Aayush2003/EEG-Data-Acquisition-System/README.md

# EEG Data Acquisition System

This repository contains all the work we've done as part of the course project in EE344: Electronic Design Lab

Team Members:
* Aayush Rajesh
* Anubhav Bhatla
* Aditya Sriram
* Ankith R
* Nithish Kumar Reddy
* Shivam Patel
