Aayush2003/EEG-Data-Acquisition-System/CAD/M4_Large_Front_Right.stl

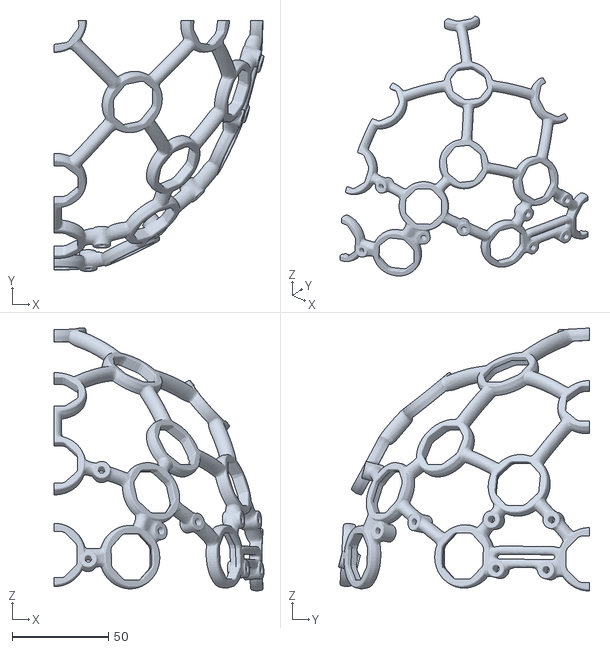
[picture p21: CAD file, 2023-04-30]
CAD/M4_Large_Front_Right.stl
108.9 x 130.1 x 136.4
