Aayush2003/EEG-Data-Acquisition-System/CAD/M4_Wire_Clip.stl

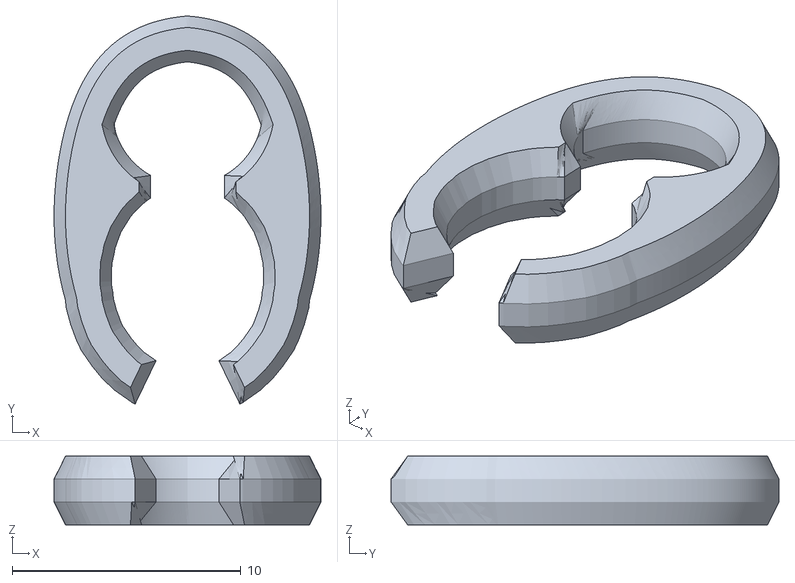
[picture p22: CAD file, 2023-04-30]
CAD/M4_Wire_Clip.stl
11.7 x 17.0 x 3.00
