Aayush2003/EEG-Data-Acquisition-System/CAD/M4_Hardware_insert_106_percent.STL

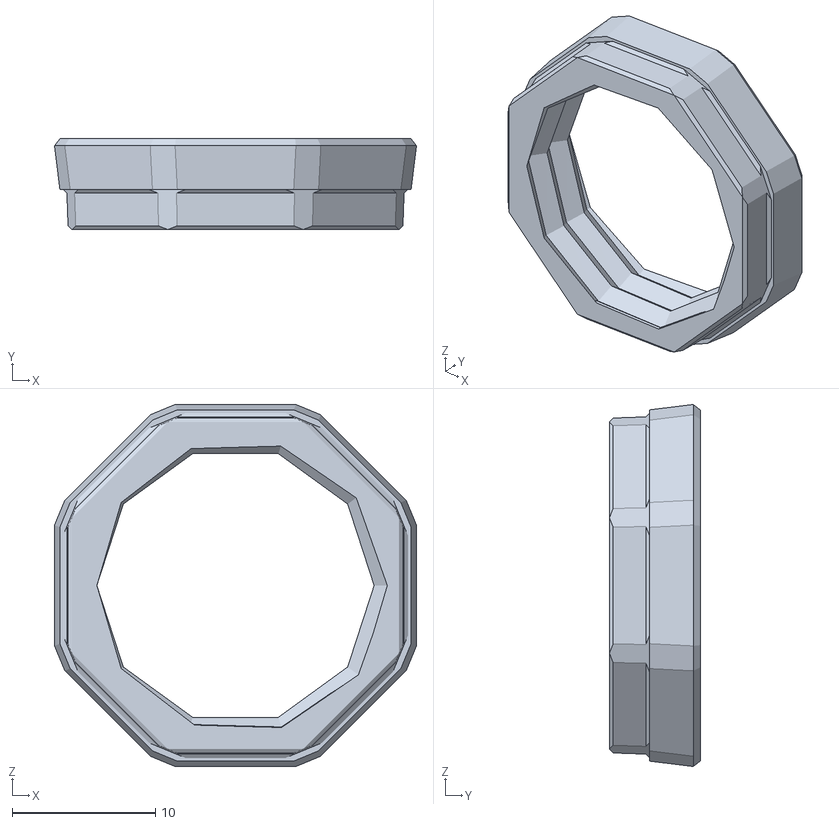
[picture p23: CAD file, 2023-04-30]
CAD/M4_Hardware_insert_106_percent.STL
25.3 x 6.35 x 25.3
