Aayush2003/EEG-Data-Acquisition-System/(list of files, cad)

Other CAD files:
CAD/M4_Large_Front_Left.stl
CAD/M4_Large_Back_Right-1.stl
CAD/M4_Large_Back_Left.stl
