Aayush2003/EEG-Data-Acquisition-System/Board Files/Main Board/OpenBCI_Board.brd

## EAGLE design Board Files/Main Board/OpenBCI_Board.brd (2023-04-30)

Schematic: OpenBCI_Board.sch

Parts:
C1: 10n; CAPC1608X85
C2, C4: 2.2u; CAPC1608X85
C3, C13, C23, C33, C41, C49, C56, C64, C124: 10u; CAPC3216X135
C5, C6, C8, C9, C15, C16, C19, C20, C24, C27, C29, C31, C35, C36, C38, C43, C44, C46, C51, C52, C54, C59, C60, C62, C67, C68, C70, C129, C131, C135, C137, C139, C141, C143, C145, C160, C162, C164, C166, C168, C170, C174, C176, C178, C180, C182, C184, C188, C190, C192, C194, C196, C198, C202, C204, C206, C208, C210, C212, C216, C218, C220, C222, C224, C226, C230, C232, C234, C236, C238, C240, C244, C246, C248, C250, C252, C254, C258, C260, C262, C264, C266, C268, C272, C274, C276, C278, C280, C282, C286, C288, C290, C292, C294, C296, C300: 1u; CAPC2012X110
C7, C12, C17, C21, C22, C26, C28, C30, C32, C37, C40, C45, C48, C53, C57, C61, C65, C69, C128, C130, C134, C136, C138, C140, C142, C144, C146, C147, C150, C151, C159, C161, C163, C165, C167, C169, C173, C175, C177, C179, C181, C183, C187, C189, C191, C193, C195, C197, C201, C203, C205, C207, C209, C211, C215, C217, C219, C221, C223, C225, C229, C231, C233, C235, C237, C239, C243, C245, C247, C249, C251, C253, C257, C259, C261, C263, C265, C267, C271, C273, C275, C277, C279, C281, C285, C287, C289, C291, C293, C295, C299: 0.1u; CAPC2012X110
C10, C11: 3.3u; CAPC1608X85
C14, C34, C42, C50, C58, C66: 22u; CAPC3216X135
C18: 10u; CAP_MCVV_A1_MTC-L
C25, C39, C47, C55, C63, C71: 100p; CAPC1608X85
C72, C73, C74, C76, C77, C78, C79, C80, C81, C82, C83, C84, C85, C86, C87, C88, C89, C90, C91, C92, C93, C94, C95, C96, C97, C98, C99, C100, C101, C102, C103, C104, C105, C106, C107, C108, C109, C110, C111, C112, C113, C114, C115, C116, C117, C118, C119, C121, C122, C123, C152, C153, C154, C155, C156: 10p; CAPC1608X85
C125, C126: 15p; CAPC1608X85
C127: 1.5n; CAPC1608X85
CR1, CR2: BAT85; DO-34_NEX
D1, D3: LED_BLUE; LEDC3216X75N_FLAT-B
D2: LED_BLUE; LEDC1005X25N_FLAT-B
ESP-BOOT: 10-XX; B3F-10XX
ESP-RST: 10-XX; B3F-10XX
FB1, FB2, FB3, FB5, FB6, FB9: FERRITE_BEAD; BEADC1608X95N
J3: SDCARD; GCT_MEM2051-00-195-00-A_REVD1
JP1, JP2, JP3, JP20, JP21, JP22: PINHD-2X5/90; 2X05/90
JP4, JP11, JP23: PINHD-1X2; 1X02
JP5, JP6: PINHD-2X2/90; 2X02/90
JP7: PINHD-1X10; 1X10
JP8: PINHD-1X8; 1X08
JP9, JP19: PINHD-1X4; 1X04
JP10: PINHD-1X3; 1X03
JP12: PINHD-1X7; 1X07
JP13, JP14, JP15, JP16, JP18: PINHD-1X1; 1X01
JP17: AGND; 1X01
MCLR/RESET: 10-XX; B3F-10XX
PIC-BOOT: PIC-BOOT; B3F-10XX
R1, R2, R4, R6, R7, R8, R61: 10k; RESC1608X60
R3, R5, R63, R66: 1k; RESC1608X60
R10, R11, R12, R13, R14, R15, R16, R17, R18, R19, R20, R21, R22, R23, R24, R25, R26, R27, R28, R29, R30, R31, R32, R33, R34, R35, R36, R37, R38, R39, R40, R41, R42, R43, R44, R45, R46, R47, R48, R49, R50, R51, R52, R53, R54, R55, R56, R57, R58, R59, R68, R69, R70, R71, R72: 5k; RESC1608X60
R62, R65: 1M; RESC1608X60
R64: 470k; RESC1608X60
R67: 0; RESC1608X60
U1: ESP-07SESP-07S_RFS-L; ESP-07S_RFS-L
U2: TPS72325DBVTDBV0005A; DBV0005A
U3: TLV70012QDDCRQ1DDC5_TEX-L; DDC5_TEX-L
U4, U6: AP2112K-3.3TRG1SOT_RG1_DIO-L; SOT_RG1_DIO-L
U5: LM2664M6; SOT95P280X145-6N
U7: LIS3DHHTRQFN; QFN_ICLX_STM
U8, U9, U10, U11, U12, U13: ADS1194CPAGPAG64-L; PAG64-L
U14, U15, U16, U17, U18, U19, U20, U21, U22, U23, U24, U25, U26, U27, U30: TPD4E1B; DCK6_TEX-L
U28: PIC32MX250F128D-50I/PTTQFP44_MC_MCH-L; TQFP44_MC_MCH-L
XTAL1: 8M; XTALRR488W45L1150T500H350B

Connections:
1N: JP20.7, R57.1, U25.4 (IO3)
1P: JP20.8, R58.1, U26.1 (IO1)
2N: JP20.5, R55.1, U25.2 (IO2)
2P: JP20.6, R56.1, U25.5 (IO4)
3N: JP20.3, R53.1, U24.4 (IO3)
3P: JP20.4, R54.1, U25.1 (IO1)
3V3: C19.1, C22.1, C23.1, D2.A, JP9.1, R1.2, R2.2, R4.2, U1.8 (VCC), U4.5 (VOUT)
4N: JP20.1, R51.1, U24.2 (IO2)
4P: JP20.2, R52.1, U24.5 (IO4)
5N: JP21.7, R49.1, U23.4 (IO3)
5P: JP21.8, R50.1, U24.1 (IO1)
6N: JP21.5, R47.1, U23.2 (IO2)
6P: JP21.6, R48.1, U23.5 (IO4)
7N: JP21.3, R45.1, U22.4 (IO3)
7P: JP21.4, R46.1, U23.1 (IO1)
8N: JP21.1, R43.1, U22.2 (IO2)
8P: JP21.2, R44.1, U22.5 (IO4)
9N: JP1.7, R41.1, U21.4 (IO3)
9P: JP1.8, R42.1, U22.1 (IO1)
10N: JP1.5, R39.1, U21.2 (IO2)
10P: JP1.6, R40.1, U21.5 (IO4)
11N: JP1.3, R37.1, U20.4 (IO3)
11P: JP1.4, R38.1, U21.1 (IO1)
12N: JP1.1, R35.1, U20.2 (IO2)
12P: JP1.2, R36.1, U20.5 (IO4)
13N: JP22.7, R33.1, U19.4 (IO3)
13P: JP22.8, R34.1, U20.1 (IO1)
14N: JP22.5, R31.1, U19.2 (IO2)
14P: JP22.6, R32.1, U19.5 (IO4)
15N: JP22.3, R29.1, U18.4 (IO3)
15P: JP22.4, R30.1, U19.1 (IO1)
16N: JP22.1, R27.1, U18.2 (IO2)
16P: JP22.2, R28.1, U18.5 (IO4)
17N: JP2.7, R25.1, U17.4 (IO3)
17P: JP2.8, R26.1, U18.1 (IO1)
18N: JP2.5, R23.1, U17.2 (IO2)
18P: JP2.6, R24.1, U17.5 (IO4)
19N: JP2.3, R21.1, U16.4 (IO3)
19P: JP2.4, R22.1, U17.1 (IO1)
20N: JP2.1, R19.1, U16.2 (IO2)
20P: JP2.2, R20.1, U16.5 (IO4)
21N: JP3.7, R17.1, U15.4 (IO3)
21P: JP3.8, R18.1, U16.1 (IO1)
22N: JP3.5, R15.1, U15.2 (IO2)
22P: JP3.6, R16.1, U15.5 (IO4)
23N: JP3.3, R13.1, U14.4 (IO3)
23P: JP3.4, R14.1, U15.1 (IO1)
24N: JP3.1, R11.1, U14.2 (IO2)
24P: JP3.2, R12.1, U14.5 (IO4)
-RAW: C4.1, C11.1, U2.2 (IN), U2.3 (EN), U5.2 (OUT)
AGND: C1.2, C2.2, C4.2, C5.2, C6.2, C11.2, C26.2, C27.2, C28.2, C29.2, C30.2, C31.2, C72.2, C73.2, C74.1, C74.2, C76.2, C77.2, C78.2, C79.2, C80.2, C81.2, C82.2, C83.2, C84.2, C85.2, C86.2, C87.2, C88.2, C89.2, C90.2, C91.2, C92.2, C93.2, C94.2, C95.2, C96.2, C97.2, C98.2, C99.2, C100.2, C101.2, C102.2, C103.2, C104.2, C105.2, C106.2, C107.2, C108.2, C109.2, C110.2, C111.2, C112.2, C113.2, C114.2, C115.2, C116.2, C117.2, C118.2, C119.2, C121.2, C122.2, C123.2, C128.2, C129.2, C130.2, C131.2, C134.2, C135.2, C136.2, C137.2, C138.2, C139.2, C140.2, C141.2, C142.2, C143.2, C144.2, C145.2, C152.2, C153.2, C154.2, C155.2, C156.2, C159.2, C160.2, C161.2, C162.2, C163.2, C164.2, C165.2, C166.2, C167.2, C168.2, C169.2, C170.2, C173.2, C174.2, C175.2, C176.2, C177.2, C178.2, C179.2, C180.2, C181.2, C182.2, C183.2, C184.2, C187.2, C188.2, C189.2, C190.2, C191.2, C192.2, C193.2, C194.2, C195.2, C196.2, C197.2, C198.2, C201.2, C202.2, C203.2, C204.2, C205.2, C206.2, C207.2, C208.2, C209.2, C210.2, C211.2, C212.2, C215.2, C216.2, C217.2, C218.2, C219.2, C220.2, C221.2, C222.2, C223.2, C224.2, C225.2, C226.2, C229.2, C230.2, C231.2, C232.2, C233.2, C234.2, C235.2, C236.2, C237.2, C238.2, C239.2, C240.2, C243.2, C244.2, C245.2, C246.2, C247.2, C248.2, C249.2, C250.2, C251.2, C252.2, C253.2, C254.2, C257.2, C258.2, C259.2, C260.2, C261.2, C262.2, C263.2, C264.2, C265.2, C266.2, C267.2, C268.2, C271.2, C272.2, C273.2, C274.2, C275.2, C276.2, C277.2, C278.2, C279.2, C280.2, C281.2, C282.2, C285.2, C286.2, C287.2, C288.2, C289.2, C290.2, C291.2, C292.2, C293.2, C294.2, C295.2, C296.2, C299.2, C300.2, FB1.2, FB2.2, FB3.2, FB5.2, FB6.2, FB9.2, JP4.2, JP5.3, JP5.4, JP6.3, JP6.4, JP8.2, JP11.1, JP12.7, JP13.1, JP14.1, JP15.1, JP16.1, JP17.1, JP23.2, R10.1, R10.2, U2.1 (GND), U3.2 (GND), U5.1 (GND), U8.31 (RESV1), U8.33 (DGND_2), U8.49 (DGND_3), U8.51 (DGND), U8.52 (CLKSEL), U8.60 (RLDINV_2), U9.31 (RESV1), U9.33 (DGND_2), U9.49 (DGND_3), U9.51 (DGND), U9.52 (CLKSEL), U9.60 (RLDINV_2), U10.31 (RESV1), U10.33 (DGND_2), U10.49 (DGND_3), U10.51 (DGND), U10.52 (CLKSEL), U10.60 (RLDINV_2), U11.31 (RESV1), U11.33 (DGND_2), U11.49 (DGND_3), U11.51 (DGND), U11.52 (CLKSEL), U11.60 (RLDINV_2), U12.31 (RESV1), U12.33 (DGND_2), U12.49 (DGND_3), U12.51 (DGND), U12.52 (CLKSEL), U12.60 (RLDINV_2), U13.31 (RESV1), U13.33 (DGND_2), U13.41 (DAISY_IN), U13.49 (DGND_3), U13.51 (DGND), U13.60 (RLDINV_2), U14.3 (GND), U15.3 (GND), U16.3 (GND), U17.3 (GND), U18.3 (GND), U19.3 (GND), U20.3 (GND), U21.3 (GND), U22.3 (GND), U23.3 (GND), U24.3 (GND), U25.3 (GND), U26.3 (GND), U27.1 (IO1), U27.3 (GND), U30.3 (GND)
AVDD: C5.1, C26.1, C27.1, C30.1, C31.1, C130.1, C131.1, C134.1, C135.1, C136.1, C137.1, C163.1, C164.1, C167.1, C168.1, C169.1, C170.1, C173.1, C174.1, C175.1, C176.1, C191.1, C192.1, C195.1, C196.1, C197.1, C198.1, C201.1, C202.1, C203.1, C204.1, C219.1, C220.1, C223.1, C224.1, C225.1, C226.1, C229.1, C230.1, C231.1, C232.1, C247.1, C248.1, C251.1, C252.1, C253.1, C254.1, C257.1, C258.1, C259.1, C260.1, C275.1, C276.1, C279.1, C280.1, C281.1, C282.1, C285.1, C286.1, C287.1, C288.1, JP5.1, JP5.2, U3.5 (OUT), U8.1 (IN8N), U8.2 (IN8P), U8.3 (IN7N), U8.4 (IN7P), U8.5 (IN6N), U8.6 (IN6P), U8.7 (IN5N), U8.8 (IN5P), U8.17 (TESTP_PACE_OUT1), U8.18 (TESTN_PACE_OUT2), U8.19 (AVDD_2), U8.21 (AVDD_3), U8.22 (AVDD_4), U8.42 (GPIO1), U8.44 (GPIO2), U8.45 (GPIO3), U8.46 (GPIO4), U8.54 (AVDD1), U8.56 (AVDD_5), U8.59 (AVDD), U9.1 (IN8N), U9.2 (IN8P), U9.3 (IN7N), U9.4 (IN7P), U9.5 (IN6N), U9.6 (IN6P), U9.7 (IN5N), U9.8 (IN5P), U9.17 (TESTP_PACE_OUT1), U9.18 (TESTN_PACE_OUT2), U9.19 (AVDD_2), U9.21 (AVDD_3), U9.22 (AVDD_4), U9.42 (GPIO1), U9.44 (GPIO2), U9.45 (GPIO3), U9.46 (GPIO4), U9.54 (AVDD1), U9.56 (AVDD_5), U9.59 (AVDD), U10.1 (IN8N), U10.2 (IN8P), U10.3 (IN7N), U10.4 (IN7P), U10.5 (IN6N), U10.6 (IN6P), U10.7 (IN5N), U10.8 (IN5P), U10.17 (TESTP_PACE_OUT1), U10.18 (TESTN_PACE_OUT2), U10.19 (AVDD_2), U10.21 (AVDD_3), U10.22 (AVDD_4), U10.42 (GPIO1), U10.44 (GPIO2), U10.45 (GPIO3), U10.46 (GPIO4), U10.54 (AVDD1), U10.56 (AVDD_5), U10.59 (AVDD), U11.1 (IN8N), U11.2 (IN8P), U11.3 (IN7N), U11.4 (IN7P), U11.5 (IN6N), U11.6 (IN6P), U11.7 (IN5N), U11.8 (IN5P), U11.17 (TESTP_PACE_OUT1), U11.18 (TESTN_PACE_OUT2), U11.19 (AVDD_2), U11.21 (AVDD_3), U11.22 (AVDD_4), U11.42 (GPIO1), U11.44 (GPIO2), U11.45 (GPIO3), U11.46 (GPIO4), U11.54 (AVDD1), U11.56 (AVDD_5), U11.59 (AVDD), U12.1 (IN8N), U12.2 (IN8P), U12.3 (IN7N), U12.4 (IN7P), U12.5 (IN6N), U12.6 (IN6P), U12.7 (IN5N), U12.8 (IN5P), U12.17 (TESTP_PACE_OUT1), U12.18 (TESTN_PACE_OUT2), U12.19 (AVDD_2), U12.21 (AVDD_3), U12.22 (AVDD_4), U12.42 (GPIO1), U12.44 (GPIO2), U12.45 (GPIO3), U12.46 (GPIO4), U12.54 (AVDD1), U12.56 (AVDD_5), U12.59 (AVDD), U13.1 (IN8N), U13.2 (IN8P), U13.3 (IN7N), U13.4 (IN7P), U13.5 (IN6N), U13.6 (IN6P), U13.7 (IN5N), U13.8 (IN5P), U13.17 (TESTP_PACE_OUT1), U13.18 (TESTN_PACE_OUT2), U13.19 (AVDD_2), U13.21 (AVDD_3), U13.22 (AVDD_4), U13.42 (GPIO1), U13.44 (GPIO2), U13.45 (GPIO3), U13.46 (GPIO4), U13.52 (CLKSEL), U13.54 (AVDD1), U13.56 (AVDD_5), U13.59 (AVDD), U27.2 (IO2)
AVSS: C2.1, C12.2, C13.2, C14.2, C15.2, C16.2, C17.2, C24.2, C25.2, C32.2, C33.2, C34.2, C35.2, C36.2, C37.2, C38.2, C39.2, C40.2, C41.2, C42.2, C43.2, C44.2, C45.2, C46.2, C47.2, C48.2, C49.2, C50.2, C51.2, C52.2, C53.2, C54.2, C55.2, C56.2, C57.2, C58.2, C59.2, C60.2, C61.2, C62.2, C63.2, C64.2, C65.2, C66.2, C67.2, C68.2, C69.2, C70.2, C71.2, C128.1, C129.1, C138.1, C139.1, C140.1, C141.1, C142.1, C143.1, C144.1, C145.1, C165.1, C166.1, C177.1, C178.1, C179.1, C180.1, C181.1, C182.1, C183.1, C184.1, C193.1, C194.1, C205.1, C206.1, C207.1, C208.1, C209.1, C210.1, C211.1, C212.1, C221.1, C222.1, C233.1, C234.1, C235.1, C236.1, C237.1, C238.1, C239.1, C240.1, C249.1, C250.1, C261.1, C262.1, C263.1, C264.1, C265.1, C266.1, C267.1, C268.1, C277.1, C278.1, C289.1, C290.1, C291.1, C292.1, C293.1, C294.1, C295.1, C296.1, JP6.1, JP6.2, U2.5 (OUT), U8.20 (AVSS_2), U8.23 (AVSS_3), U8.25 (VREFN), U8.32 (AVSS_4), U8.53 (AVSS1), U8.57 (AVSS_5), U8.58 (AVSS), U9.20 (AVSS_2), U9.23 (AVSS_3), U9.25 (VREFN), U9.32 (AVSS_4), U9.53 (AVSS1), U9.57 (AVSS_5), U9.58 (AVSS), U10.20 (AVSS_2), U10.23 (AVSS_3), U10.25 (VREFN), U10.32 (AVSS_4), U10.53 (AVSS1), U10.57 (AVSS_5), U10.58 (AVSS), U11.20 (AVSS_2), U11.23 (AVSS_3), U11.25 (VREFN), U11.32 (AVSS_4), U11.53 (AVSS1), U11.57 (AVSS_5), U11.58 (AVSS), U12.20 (AVSS_2), U12.23 (AVSS_3), U12.25 (VREFN), U12.32 (AVSS_4), U12.53 (AVSS1), U12.57 (AVSS_5), U12.58 (AVSS), U13.20 (AVSS_2), U13.23 (AVSS_3), U13.25 (VREFN), U13.32 (AVSS_4), U13.53 (AVSS1), U13.57 (AVSS_5), U13.58 (AVSS), U26.4 (IO3)
BATT1: CR1.2, JP4.1
BATT2: CR2.2, JP23.1
BOOT_EN: JP7.9, PIC-BOOT.1 (S), PIC-BOOT.2 (S1), R64.2, U28.2 (RPC6/PMA1/RC6)
CS_ACC: U7.4 (CS), U28.38 (RPC5/PMA3/RC5)
CS_ADC: U8.39 (!CS), U9.39 (!CS), U10.39 (!CS), U11.39 (!CS), U12.39 (!CS), U13.39 (!CS), U28.33 (SOSCI/RPB4/RB4)
CS_DAISY: JP8.8, U28.25 (AN6/RPC0/RC0)
CS_SD: J3.P2 (DATA3/CD), U28.37 (RPC4/PMA4/RC4)
DAISY_3_4: U10.41 (DAISY_IN), U11.43 (DOUT)
DGND: C3.2, C7.2, C8.2, C9.2, C18.1, C19.2, C20.2, C21.2, C22.2, C23.2, C124.1, C125.2, C126.2, C146.2, C147.2, C150.2, C151.1, ESP-BOOT.1 (S), ESP-BOOT.2 (S1), ESP-RST.3, ESP-RST.4 (P1), FB1.1, FB2.1, FB3.1, FB5.1, FB6.1, FB9.1, J3.P6 (VSS), JP7.3, JP7.10, JP9.2, JP10.3, JP18.1, MCLR/RESET.3, MCLR/RESET.4 (P1), R5.2, R6.1, R63.1, R64.1, U1.9 (GND), U4.2 (GND), U6.2 (GND), U7.9 (GND_2), U7.10 (GND_3), U7.11 (GND_4), U7.12 (GND_5), U7.13 (GND_6), U7.14 (GND_7), U7.15 (GND_8), U7.16 (GND), U28.6 (VSS_2), U28.15 (AN9/C3INA/RPB15/SCK2/CTED6/PMCS1/RB15), U28.16 (AVSS), U28.19 (PGED3/VREF+/CVREF+/AN0/C3INC/RPA0/CTED1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), U28.23 (AN4/C1INB/C2IND/RPB2/SDA2/CTED13/PMD2/R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), U28.24 (AN5/C1INA/C2INC/RTCC/RPB3/SCL2/PMWR/RB3), U28.27 (AN8/RPC2/PMA2/RC2), U28.29 (VSS_3), U28.32 (TDO/RPA8/PMA8/RA8), U28.35 (TDI/RPA9/PMA9/RA9), U28.39 (VSS), U28.44 (RPB8/SCL1/CTED10/PMD4/RB8)
DRDY: U8.47 (!DRDY), U28.43 (RPB7/CTED3/PMD5/INT0/RB7)
DVDD: C3.1, C6.1, C7.1, C8.1, C18.2, C21.1, C28.1, C29.1, C146.1, C147.1, C150.1, C159.1, C160.1, C161.1, C162.1, C187.1, C188.1, C189.1, C190.1, C215.1, C216.1, C217.1, C218.1, C243.1, C244.1, C245.1, C246.1, C271.1, C272.1, C273.1, C274.1, C299.1, C300.1, J3.P4 (VDD), JP7.2, JP8.1, PIC-BOOT.3, PIC-BOOT.4 (P1), R61.1, U3.1 (IN), U3.3 (EN), U5.4 (!SD), U5.5 (V+), U6.5 (VOUT), U7.7 (VDDIO), U7.8 (VDD), U8.35 (!PWDN), U8.48 (DVDD_2), U8.50 (DVDD), U9.35 (!PWDN), U9.48 (DVDD_2), U9.50 (DVDD), U10.35 (!PWDN), U10.48 (DVDD_2), U10.50 (DVDD), U11.35 (!PWDN), U11.48 (DVDD_2), U11.50 (DVDD), U12.35 (!PWDN), U12.48 (DVDD_2), U12.50 (DVDD), U13.35 (!PWDN), U13.48 (DVDD_2), U13.50 (DVDD), U28.10 (VUSB3V3), U28.17 (AVDD), U28.28 (VDD_2), U28.40 (VDD), U28.42 (VBUS)
ESP_SS: R6.2, U1.10 (IO15), U28.1 (RPB9/SDA1/CTED4/PMD3/RB9)
GPIO1: JP19.1, U28.4 (RPC8/PMA5/RC8)
GPIO2: JP19.2, U28.5 (RPC9/CTED7/PMA6/RC9)
GPIO3: JP19.3, U28.8 (PGED2/RPB10/D+/CTED11/RB10)
GPIO4: JP19.4, U28.9 (PGEC2/RPB11/D-/RB11)
IN1N: C123.1, R57.2, U8.15 (IN1N)
IN1P: C122.1, R58.2, U8.16 (IN1P)
IN2N: C117.1, R55.2, U8.13 (IN2N)
IN2P: C116.1, R56.2, U8.14 (IN2P)
IN3N: C119.1, R53.2, U8.11 (IN3N)
IN3P: C118.1, R54.2, U8.12 (IN3P)
IN4N: C113.1, R51.2, U8.9 (IN4N)
IN4P: C112.1, R52.2, U8.10 (IN4P)
IN5N: C115.1, R49.2, U9.15 (IN1N)
IN5P: C114.1, R50.2, U9.16 (IN1P)
IN6N: C109.1, R47.2, U9.13 (IN2N)
IN6P: C108.1, R48.2, U9.14 (IN2P)
IN7N: C111.1, R45.2, U9.11 (IN3N)
IN7P: C110.1, R46.2, U9.12 (IN3P)
IN8N: C105.1, R43.2, U9.9 (IN4N)
IN8P: C104.1, R44.2, U9.10 (IN4P)
IN9N: C107.1, R41.2, U10.15 (IN1N)
IN9P: C106.1, R42.2, U10.16 (IN1P)
IN10N: C101.1, R39.2, U10.13 (IN2N)
IN10P: C100.1, R40.2, U10.14 (IN2P)
IN11N: C103.1, R37.2, U10.11 (IN3N)
IN11P: C102.1, R38.2, U10.12 (IN3P)
IN12N: C97.1, R35.2, U10.9 (IN4N)
IN12P: C96.1, R36.2, U10.10 (IN4P)
IN13N: C99.1, R33.2, U11.15 (IN1N)
IN13P: C98.1, R34.2, U11.16 (IN1P)
IN14N: C93.1, R31.2, U11.13 (IN2N)
IN14P: C92.1, R32.2, U11.14 (IN2P)
IN15N: C95.1, R29.2, U11.11 (IN3N)
IN15P: C94.1, R30.2, U11.12 (IN3P)
IN16N: C89.1, R27.2, U11.9 (IN4N)
IN16P: C88.1, R28.2, U11.10 (IN4P)
IN17N: C91.1, R25.2, U12.15 (IN1N)
IN17P: C90.1, R26.2, U12.16 (IN1P)
IN18N: C85.1, R23.2, U12.13 (IN2N)
IN18P: C84.1, R24.2, U12.14 (IN2P)
IN19N: C87.1, R21.2, U12.11 (IN3N)
IN19P: C86.1, R22.2, U12.12 (IN3P)
IN20N: C81.1, R19.2, U12.9 (IN4N)
IN20P: C80.1, R20.2, U12.10 (IN4P)
IN21N: C83.1, R17.2, U13.15 (IN1N)
IN21P: C82.1, R18.2, U13.16 (IN1P)
IN22N: C77.1, R15.2, U13.13 (IN2N)
IN22P: C76.1, R16.2, U13.14 (IN2P)
IN23N: C79.1, R13.2, U13.11 (IN3N)
IN23P: C78.1, R14.2, U13.12 (IN3P)
IN24N: C73.1, R11.2, U13.9 (IN4N)
IN24P: C72.1, R12.2, U13.10 (IN4P)
INT1: U7.6 (INT1), U28.21 (PGED1/AN2/C1IND/C2INB/C3IND/RPB0/PMD0/R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)
MCLK: JP8.6, U8.37 (CLK), U9.37 (CLK), U10.37 (CLK), U11.37 (CLK), U12.37 (CLK), U13.37 (CLK)
MCLR: JP7.1, R66.1, U28.18 (!MCLR)
MISO_1: JP8.3, JP12.1, U8.43 (DOUT), U28.41 (RPB5/USBID/RB5)
MISO_2: J3.P7 (DATA0), JP12.3, U1.6 (IO12), U7.3 (SDO), U28.34 (SOSCO/RPA4/T1CK/CTED9/RA4)
MOSI_1: JP8.7, JP12.2, U8.34 (DIN), U9.34 (DIN), U10.34 (DIN), U11.34 (DIN), U12.34 (DIN), U13.34 (DIN), U28.20 (PGEC3/VREF-/CVREF-/AN1/RPA1/CTED2/PMD6/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)
MOSI_2: J3.P3 (CMD), JP12.4, U1.7 (IO13), U7.2 (SDI), U28.22 (PGEC1/AN3/C1INC/C2INA/RPB1/CTED12/PMD1/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)
unnamed: R2.1, U1.3 (EN)
unnamed: ESP-RST.1 (S), ESP-RST.2 (S1), R1.1, U1.1 (RST)
unnamed: D1.A, U1.14 (IO5)
unnamed: D1.C, R5.1
unnamed: ESP-BOOT.3, ESP-BOOT.4 (P1), R3.1, U1.12 (IO0)
unnamed: D2.C, R3.2
unnamed: R4.1, U1.11 (IO2)
unnamed: C1.1, U2.4 (FB)
unnamed: R7.2, U4.3 (EN)
unnamed: C20.1, CR2.1, R7.1, U4.1 (VIN)
unnamed: C10.1, U5.6 (CAP+)
unnamed: C10.2, U5.3 (CAP-)
unnamed: R8.2, U6.3 (EN)
unnamed: D3.A, R67.1
unnamed: C151.2, MCLR/RESET.1 (S), MCLR/RESET.2 (S1), R61.2, R66.2
unnamed: C12.1, C13.1, U8.24 (VREFP)
unnamed: C14.1, U8.28 (VCAP1)
unnamed: C15.1, U8.30 (VCAP2)
unnamed: C16.1, U8.26 (VCAP4)
unnamed: C17.1, C24.1, U8.55 (VCAP3)
unnamed: C25.1, U8.64 (WCT)
unnamed: C32.1, C33.1, U9.24 (VREFP)
unnamed: C34.1, U9.28 (VCAP1)
unnamed: C35.1, U9.30 (VCAP2)
unnamed: C36.1, U9.26 (VCAP4)
unnamed: C37.1, C38.1, U9.55 (VCAP3)
unnamed: C39.1, U9.64 (WCT)
unnamed: C40.1, C41.1, U10.24 (VREFP)
unnamed: C42.1, U10.28 (VCAP1)
unnamed: C43.1, U10.30 (VCAP2)
unnamed: C44.1, U10.26 (VCAP4)
unnamed: C45.1, C46.1, U10.55 (VCAP3)
unnamed: C47.1, U10.64 (WCT)
unnamed: C48.1, C49.1, U11.24 (VREFP)
unnamed: C50.1, U11.28 (VCAP1)
unnamed: C51.1, U11.30 (VCAP2)
unnamed: C52.1, U11.26 (VCAP4)
unnamed: C53.1, C54.1, U11.55 (VCAP3)
unnamed: C55.1, U11.64 (WCT)
unnamed: C124.2, U28.7 (VCAP)
unnamed: C125.1, R65.2, U28.31 (OSC2/CLKO/RPA3/RA3), XTAL1.2
unnamed: C126.1, R65.1, U28.30 (OSC1/CLKI/RPA2/RA2), XTAL1.1
unnamed: C127.1, R62.2, U13.63 (RLDOUT)
unnamed: C56.1, C57.1, U12.24 (VREFP)
unnamed: C58.1, U12.28 (VCAP1)
unnamed: C59.1, U12.30 (VCAP2)
unnamed: C60.1, U12.26 (VCAP4)
unnamed: C61.1, C62.1, U12.55 (VCAP3)
unnamed: C63.1, U12.64 (WCT)
unnamed: D3.C, R63.2
unnamed: C64.1, C65.1, U13.24 (VREFP)
unnamed: C66.1, U13.28 (VCAP1)
unnamed: C67.1, U13.30 (VCAP2)
unnamed: C68.1, U13.26 (VCAP4)
unnamed: C69.1, C70.1, U13.55 (VCAP3)
unnamed: C71.1, U13.64 (WCT)
unnamed: U12.41 (DAISY_IN), U13.43 (DOUT)
unnamed: U11.41 (DAISY_IN), U12.43 (DOUT)
unnamed: U9.41 (DAISY_IN), U10.43 (DOUT)
unnamed: U8.41 (DAISY_IN), U9.43 (DOUT)
PGC: JP7.5, U28.13 (PGEC/TCK/CTED8/PMA7/RA7)
PGD: JP7.4, R67.2, U28.12 (PGED/TMS/PMA10/RA10)
RAW: C9.1, CR1.1, R8.1, U6.1 (VIN)
RESET: JP8.5, JP12.6, U8.36 (!RESET), U9.36 (!RESET), U10.36 (!RESET), U11.36 (!RESET), U12.36 (!RESET), U13.36 (!RESET), U28.26 (AN7/RPC1/RC1)
RLD1: JP20.10, R59.1, U26.2 (IO2)
RLD2: JP21.10, R71.1, U30.5 (IO4)
RLD3: JP1.10, R70.1, U30.2 (IO2)
RLD4: JP22.10, R69.1, U30.1 (IO1)
RLD5: JP2.10, R68.1, U27.4 (IO3)
RLD6: JP3.10, R72.1, U27.5 (IO4)
RLDIN1: C121.1, R59.2, U8.62 (RLDIN)
RLDIN2: C152.1, R71.2, U9.62 (RLDIN)
RLDIN3: C153.1, R70.2, U10.62 (RLDIN)
RLDIN4: C154.1, R69.2, U11.62 (RLDIN)
RLDIN5: C155.1, R68.2, U12.62 (RLDIN)
RLDIN6: C156.1, R72.2, U13.62 (RLDIN)
RLDINV: C127.2, JP11.2, R62.1, U8.61 (RLDINV), U9.61 (RLDINV), U10.61 (RLDINV), U11.61 (RLDINV), U12.61 (RLDINV), U13.61 (RLDINV)
RXD: JP9.3, U1.15 (RXD0)
SCLK: J3.P5 (CLK), JP8.4, JP12.5, U1.5 (IO14), U7.1 (SPC), U8.40 (SCLK), U9.40 (SCLK), U10.40 (SCLK), U11.40 (SCLK), U12.40 (SCLK), U13.40 (SCLK), U28.14 (CVREFOUT/AN10/C3INB/RPB14/VBUSON/SCK1/C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)
SRB1: JP20.9
SRB2: JP21.9
SRB3: JP1.9
SRB4: JP22.9
SRB5: JP2.9
SRB6: JP3.9
START: U8.38 (START), U9.38 (START), U10.38 (START), U11.38 (START), U12.38 (START), U13.38 (START), U28.36 (AN12/RPC3/RC3)
TXD: JP9.4, U1.16 (TXDO)
U1RX: JP10.1, U28.11 (AN11/RPB13/CTPLS/PMRD/RB13)
U1TX: JP10.2, U28.3 (RPC7/PMA0/RC7)

Notes on the sheet:
Daisy-Chain ADCs (Part 1)
ESD Protection
ADS 1194
Daisy-Chain ADCs (Part 2)
Wi-Fi Module
Power Components
Battery Connectors
Voltage Inverter
+2.5V Regulator
-2.5V Regulator
3.3V Regulator
3.3V Regulator (Wi-Fi)
Peripherals
Accelerometer
SD Card
PIC32 Microcontroller
Pin Headers
PICkit4
Daisy
Electrode Inputs
Wi-Fi Programming Pins
Ferrite Beads
UART
SPI Test
GND Test
uC GPIO

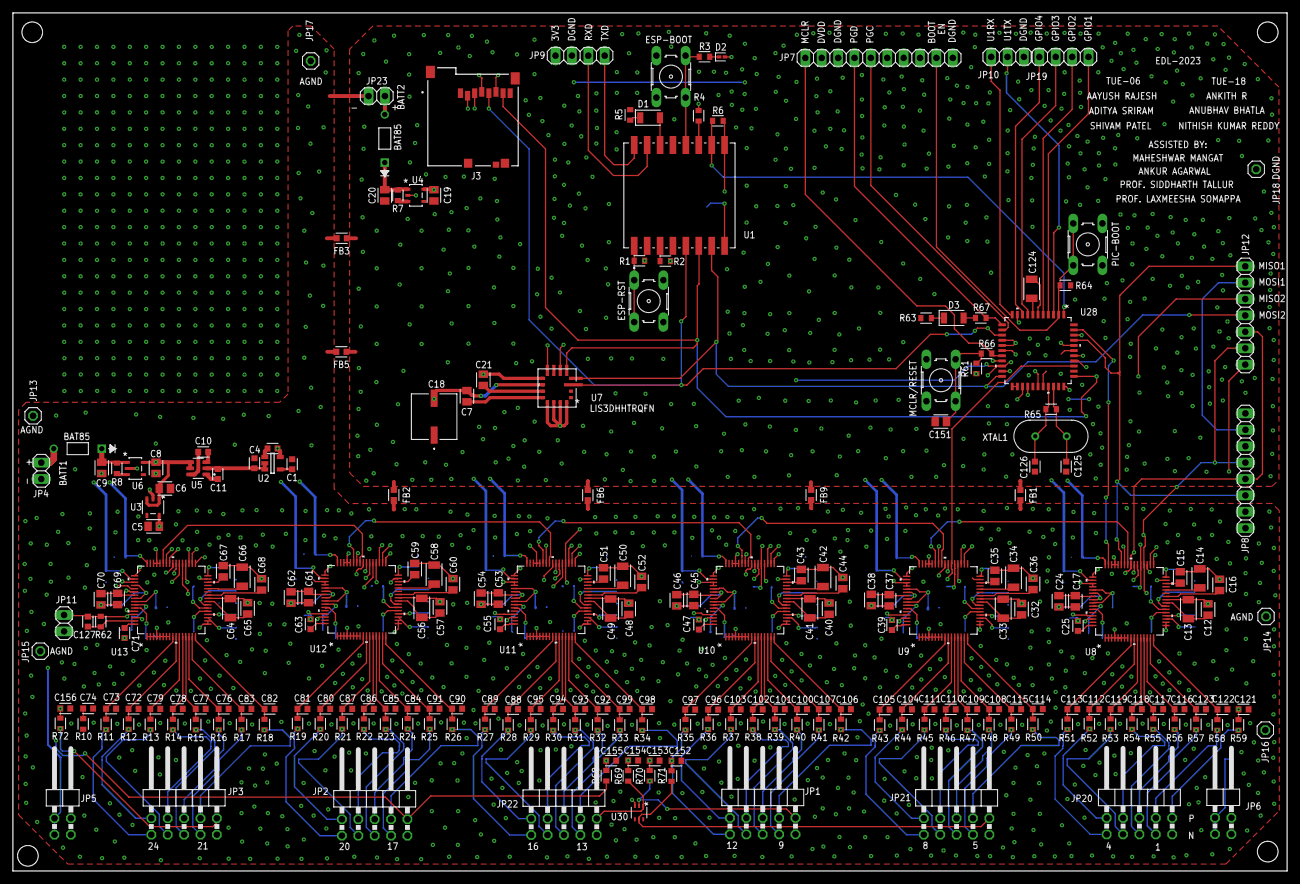
[picture p24: board OpenBCI_Board.brd from above]

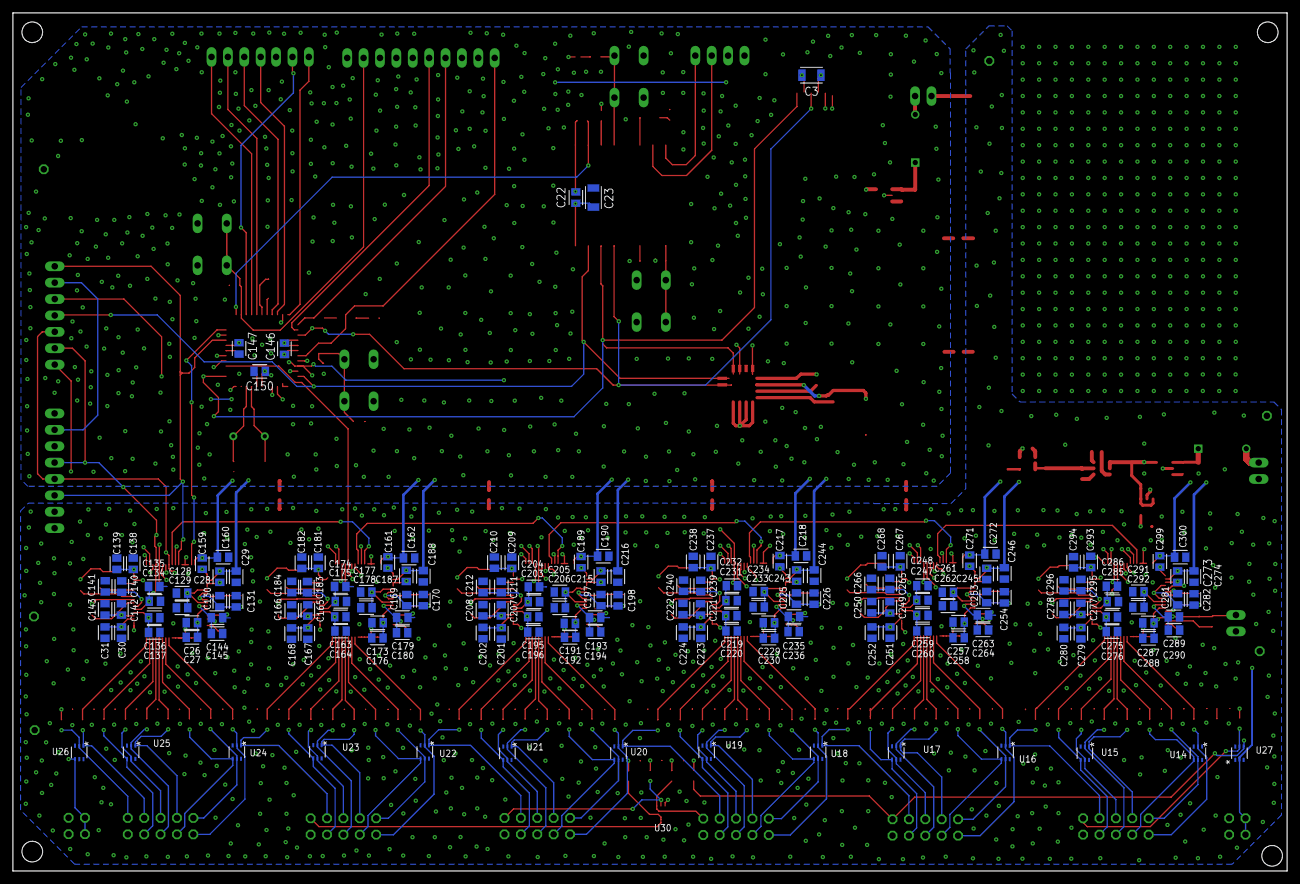
[picture p25: board OpenBCI_Board.brd from below]

Board: 4 copper layers, 197.5 x 133.0 mm, 411 parts (164 on the bottom side), 207 nets.
