Aayush2003/EEG-Data-Acquisition-System/Board Files/Base ADC Board/ADC_Test.brd

## EAGLE design Board Files/Base ADC Board/ADC_Test.brd (2023-04-30)

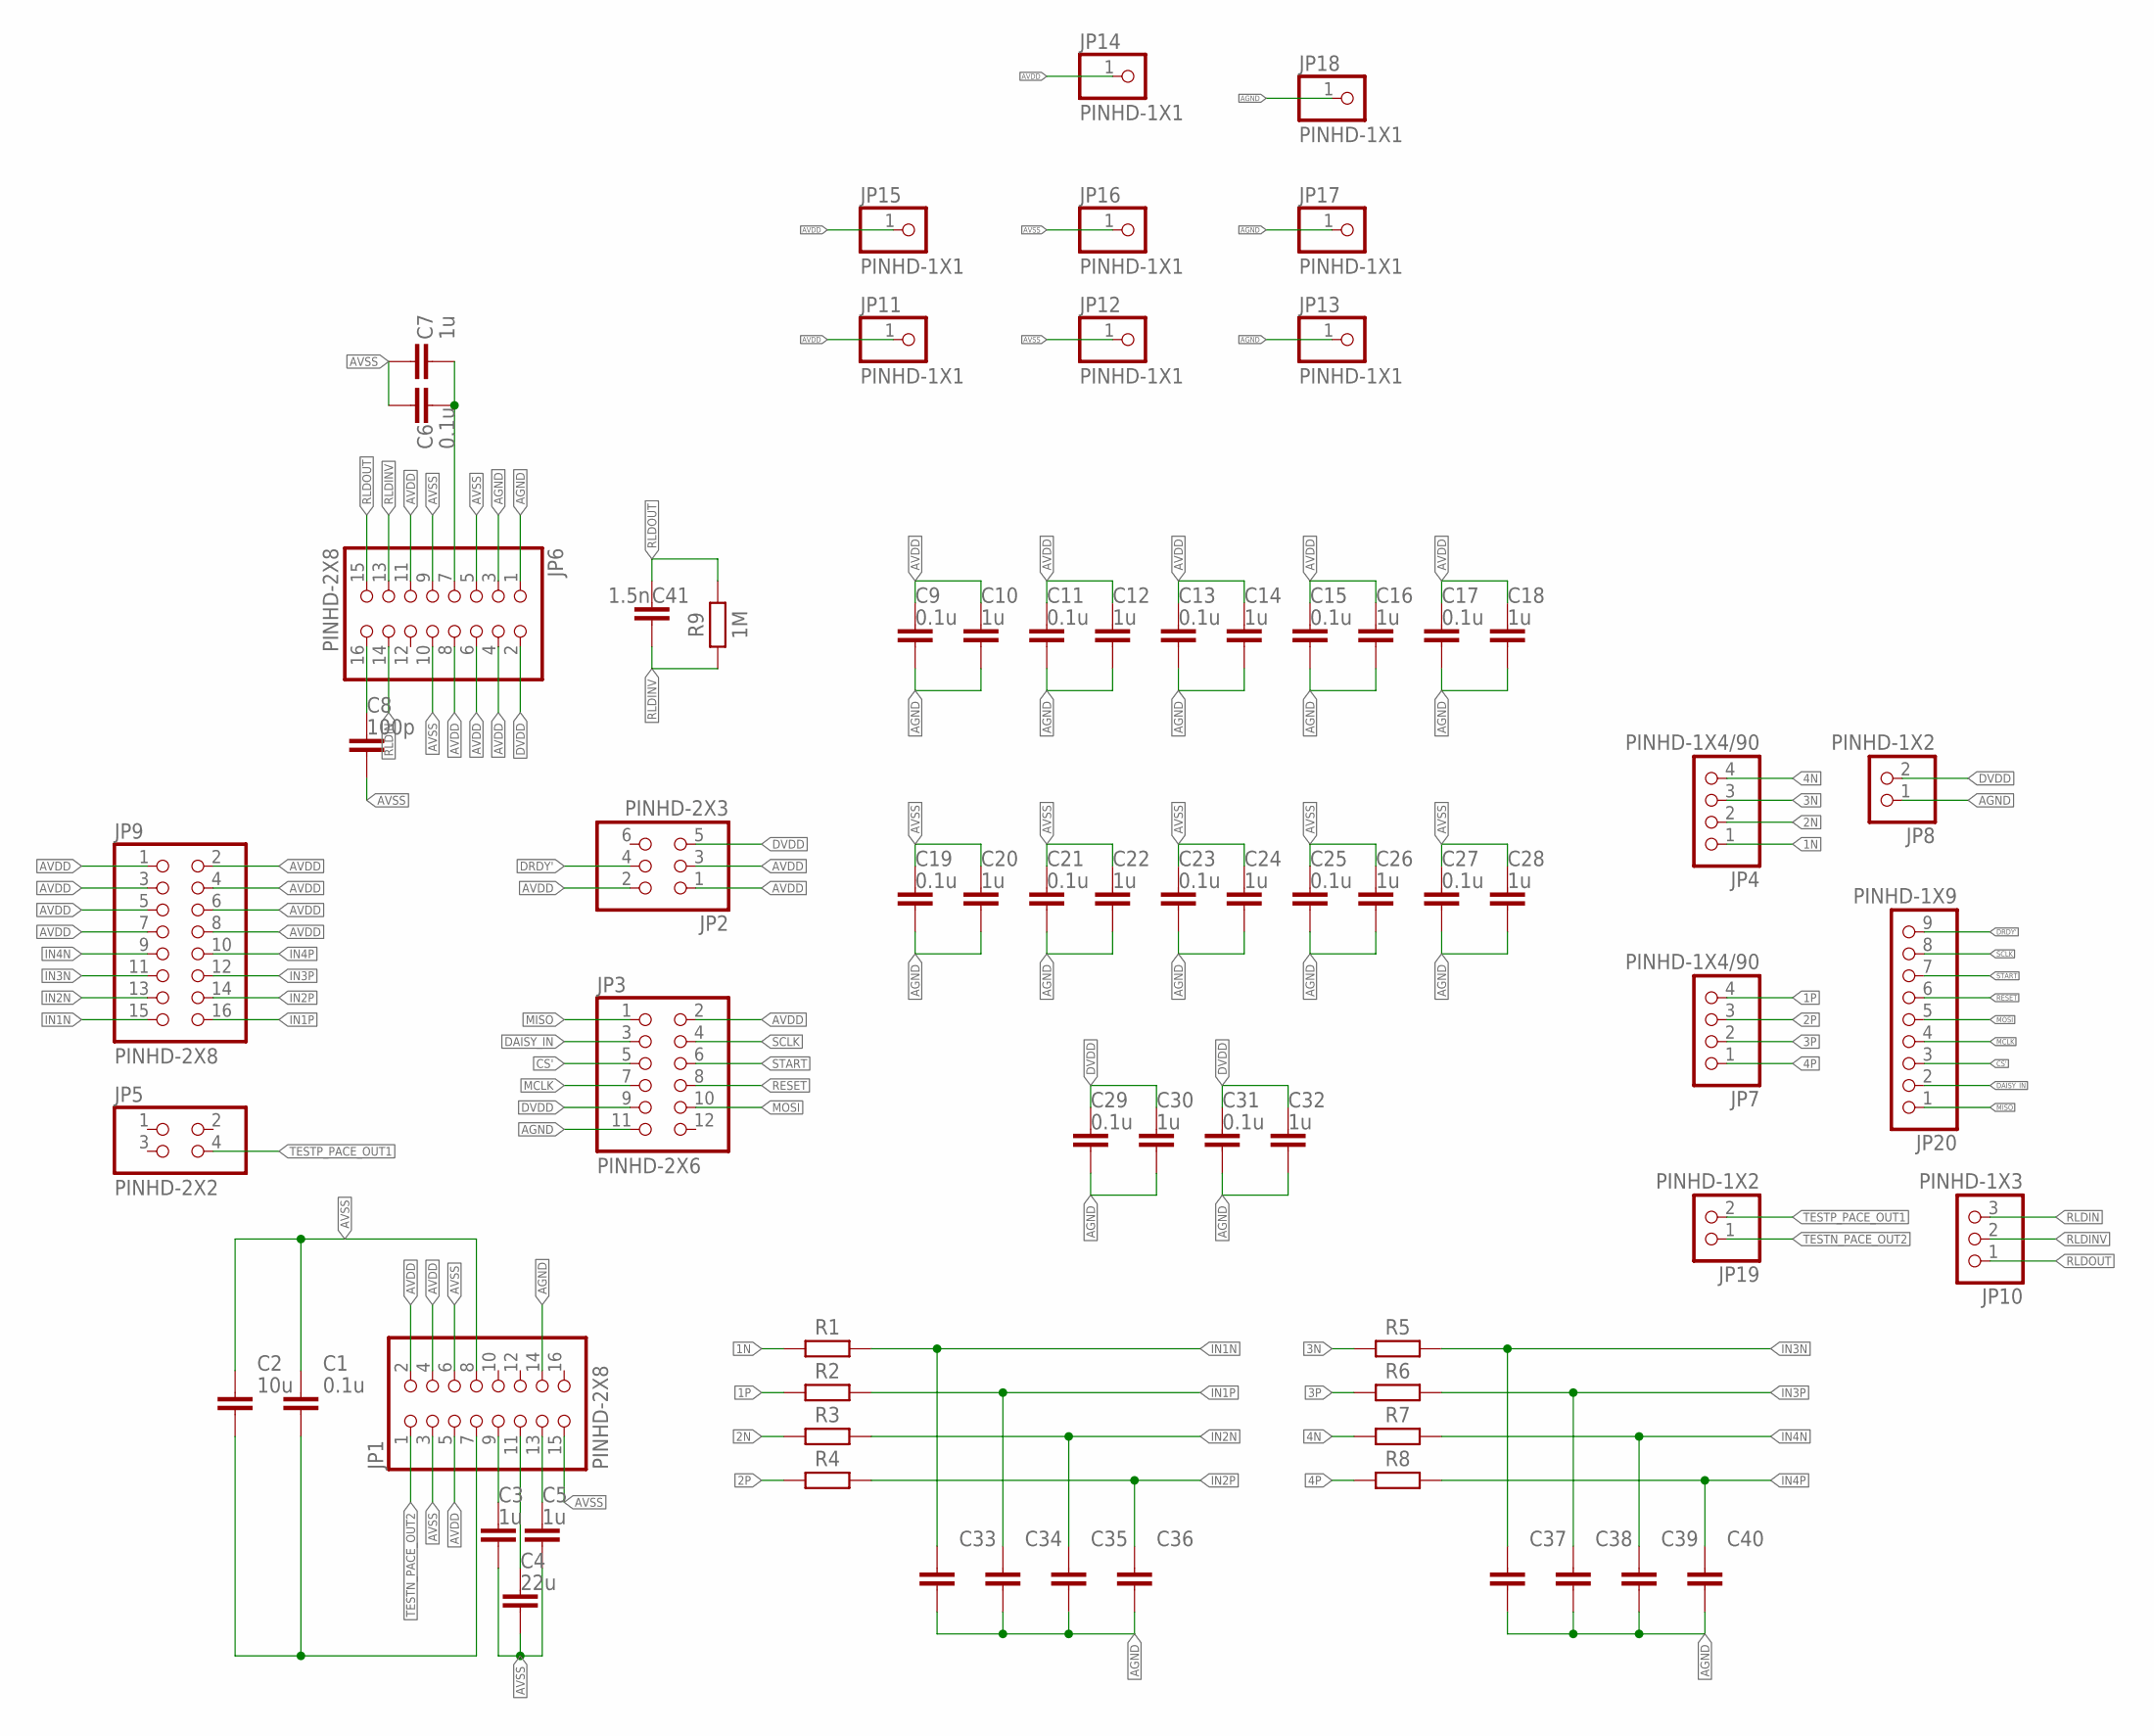
[picture p26: schematic ADC_Test.sch]

Parts:
C1, C6, C9, C11, C13, C15, C17, C19, C21, C23, C25, C27, C29, C31: 0.1u; CAPC2012X110
C2: 10u; CAPC2012X110
C3, C5, C7, C10, C12, C14, C16, C18, C20, C22, C24, C26, C28, C30, C32: 1u; CAPC2012X110
C4: 22u; CAPC2012X110
C8: 100p; CAPC2012X110
C33, C34, C35, C36, C37, C38, C39, C40: C_CHIP-0805(2012-METRIC); CAPC2012X110
C41: 1.5n; CAPC2012X110
JP1, JP6, JP9: PINHD-2X8; 2X08
JP2: PINHD-2X3; 2X03
JP3: PINHD-2X6; 2X06
JP4, JP7: PINHD-1X4/90; 1X04/90
JP5: PINHD-2X2; 2X02
JP8, JP19: PINHD-1X2; 1X02
JP10: PINHD-1X3; 1X03
JP11, JP12, JP13, JP14, JP15, JP16, JP17, JP18: PINHD-1X1; 1X01
JP20: PINHD-1X9; 1X09
R1, R2, R3, R4, R5, R6, R7, R8: R_CHIP-1206(3216-METRIC); RESC3216X70
R9: 1M; RESC3216X70

Connections:
1N: JP4.1, R1.1
1P: JP7.4, R2.1
2N: JP4.2, R3.1
2P: JP7.3, R4.1
3N: JP4.3, R5.1
3P: JP7.2, R6.1
4N: JP4.4, R7.1
4P: JP7.1, R8.1
AGND: C9.2, C10.2, C11.2, C12.2, C13.2, C14.2, C15.2, C16.2, C17.2, C18.2, C19.2, C20.2, C21.2, C22.2, C23.2, C24.2, C25.2, C26.2, C27.2, C28.2, C29.2, C30.2, C31.2, C32.2, C33.2, C34.2, C35.2, C36.2, C37.2, C38.2, C39.2, C40.2, JP1.14, JP3.11, JP6.1, JP6.3, JP8.1, JP13.1, JP17.1, JP18.1
AVDD: C9.1, C10.1, C11.1, C12.1, C13.1, C14.1, C15.1, C16.1, C17.1, C18.1, JP1.2, JP1.4, JP1.5, JP2.1, JP2.2, JP2.3, JP3.2, JP6.4, JP6.6, JP6.8, JP6.11, JP9.1, JP9.2, JP9.3, JP9.4, JP9.5, JP9.6, JP9.7, JP9.8, JP11.1, JP14.1, JP15.1
AVSS: C1.1, C2.1, C3.2, C4.2, C5.2, C6.1, C7.1, C8.2, C19.1, C20.1, C21.1, C22.1, C23.1, C24.1, C25.1, C26.1, C27.1, C28.1, JP1.3, JP1.6, JP1.8, JP1.15, JP6.5, JP6.9, JP6.10, JP12.1, JP16.1
CS': JP3.5, JP20.3
DAISY_IN: JP3.3, JP20.2
DRDY': JP2.4, JP20.9
DVDD: C29.1, C30.1, C31.1, C32.1, JP2.5, JP3.9, JP6.2, JP8.2
IN1N: C33.1, JP9.15, R1.2
IN1P: C34.1, JP9.16, R2.2
IN2N: C35.1, JP9.13, R3.2
IN2P: C36.1, JP9.14, R4.2
IN3N: C37.1, JP9.11, R5.2
IN3P: C38.1, JP9.12, R6.2
IN4N: C39.1, JP9.9, R7.2
IN4P: C40.1, JP9.10, R8.2
MCLK: JP3.7, JP20.4
MISO: JP3.1, JP20.1
MOSI: JP3.10, JP20.5
unnamed: C3.1, JP1.9
unnamed: C4.1, JP1.11
unnamed: C5.1, JP1.13
unnamed: C6.2, C7.2, JP6.7
unnamed: C8.1, JP6.16
unnamed: C1.2, C2.2, JP1.7
RESET: JP3.8, JP20.6
RLDIN: JP6.14, JP10.3
RLDINV: C41.2, JP6.13, JP10.2, R9.1
RLDOUT: C41.1, JP6.15, JP10.1, R9.2
SCLK: JP3.4, JP20.8
START: JP3.6, JP20.7
TESTN_PACE_OUT2: JP1.1, JP19.1
TESTP_PACE_OUT1: JP5.4, JP19.2

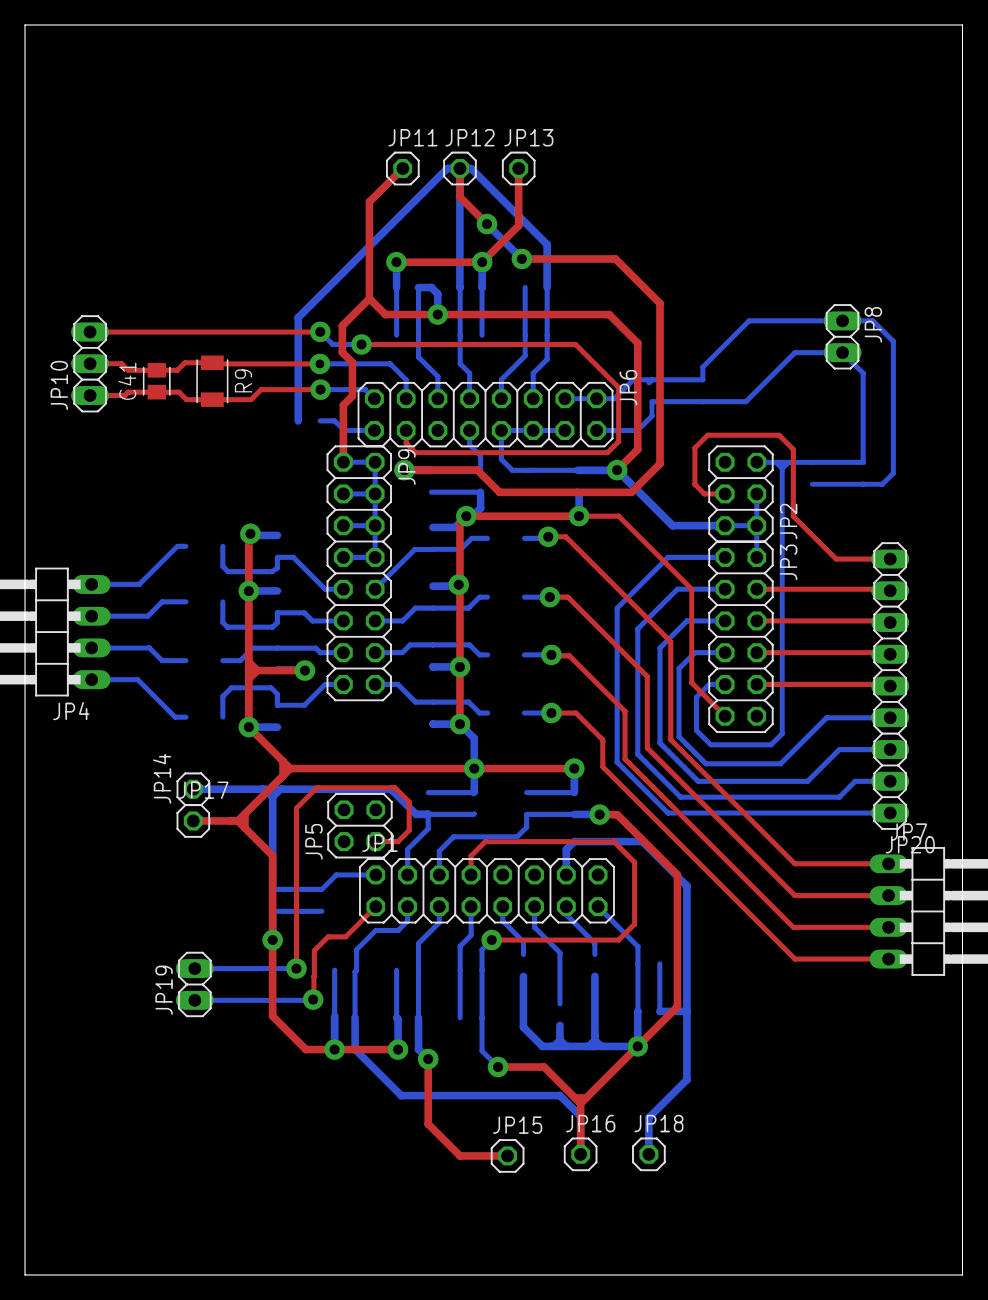
[picture p27: board ADC_Test.brd from above]

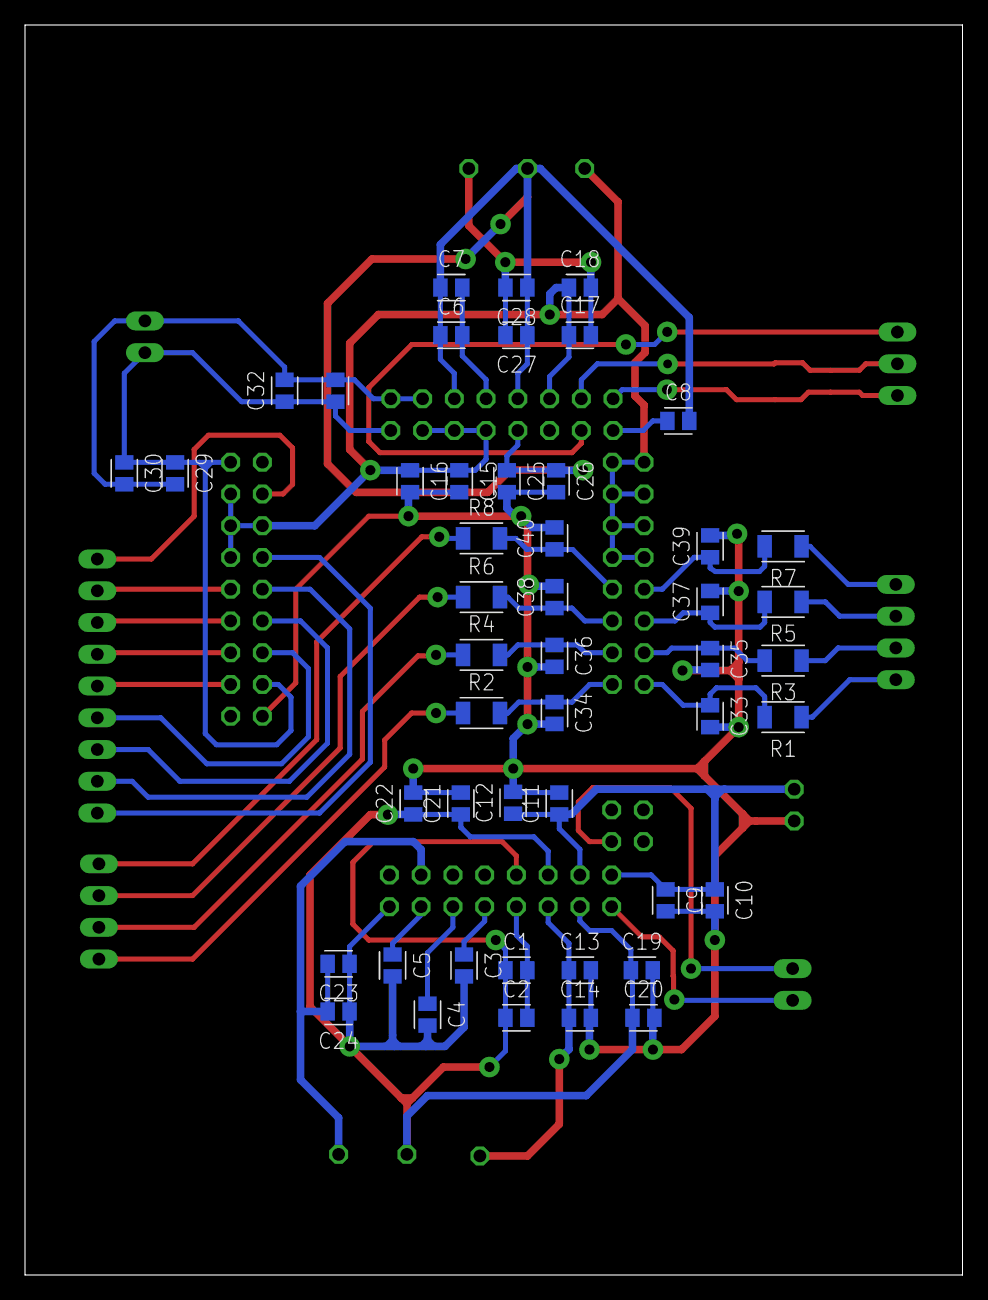
[picture p28: board ADC_Test.brd from below]

Board: 2 copper layers, 75.0 x 100.0 mm, 70 parts (48 on the bottom side), 40 nets.
