Aayush2003/EEG-Data-Acquisition-System/(commit log)

2023-04-30 Added all files
    [ADC_Test.brd, ADC_Test.sch, Daisy_Test.brd, Daisy_Test.sch, M4_Hardware_insert_106_percent.STL, M4_Large_Back_Left.stl, M4_Large_Back_Right-1.stl, M4_Large_Front_Left.stl]
2023-06-01 Create README.md for PCB Design
