Aayush2003/EEG-Data-Acquisition-System/(notices)

Notices in the files:
parts and their libraries:
ADS1194CPAG: COPYRIGHT: Copyright (C) 2023 Ultra Librarian. All rights reserved.
